william-saxton/crkbd-ice-trackball/cho-corne-ice/pcb/svg/cho-corne-ice-brd.png

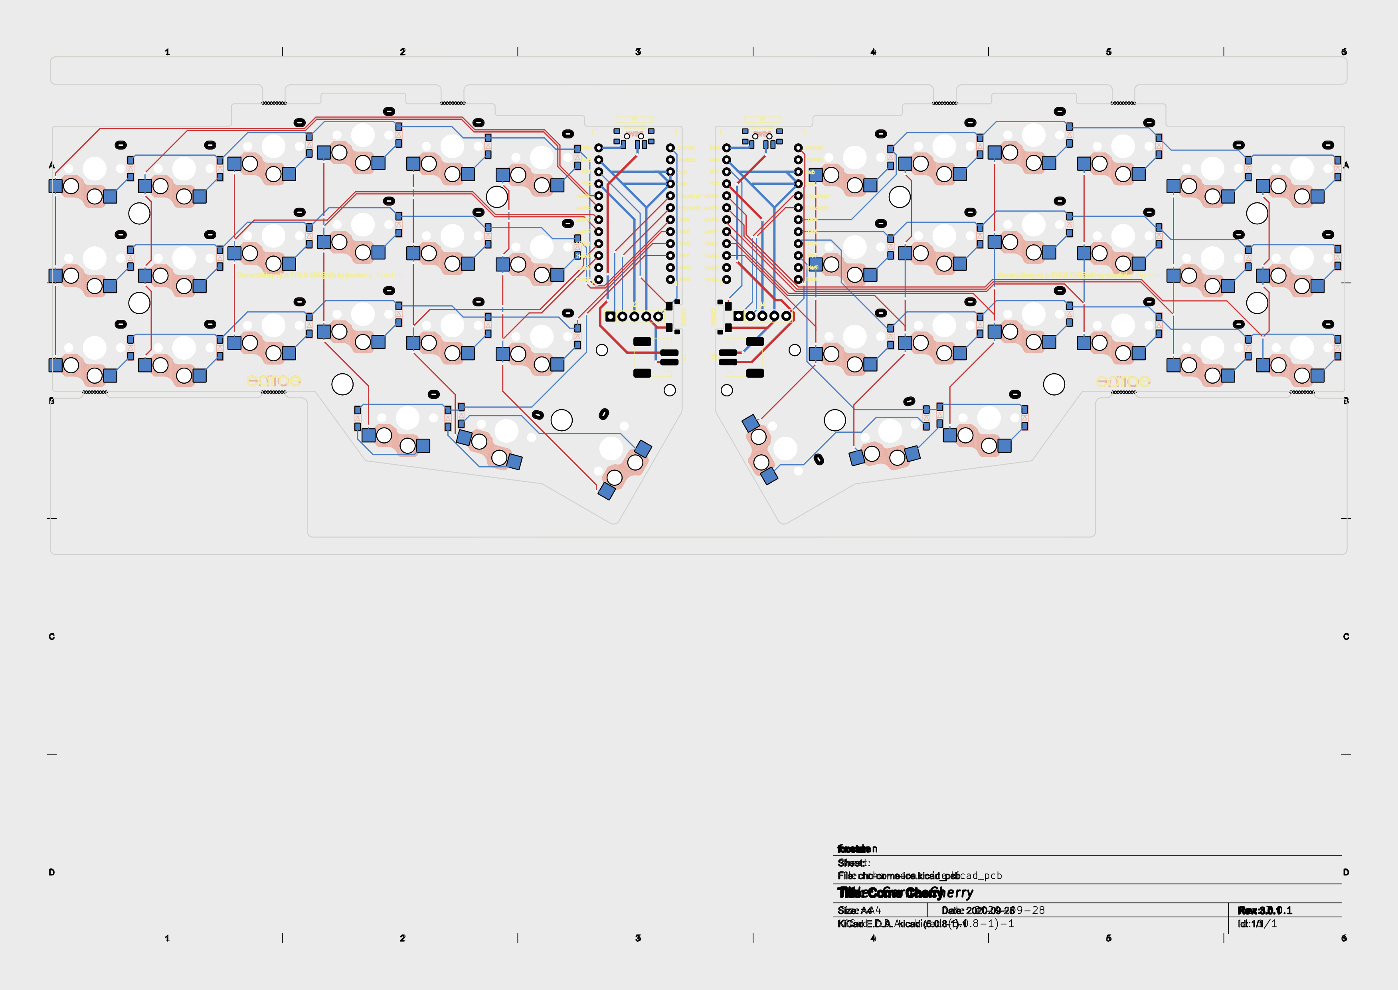
cho-corne-ice/pcb/svg/cho-corne-ice-brd.png
