william-saxton/crkbd-ice-trackball/cho-corne-ice/pcb/svg/cho-corne-ice.png

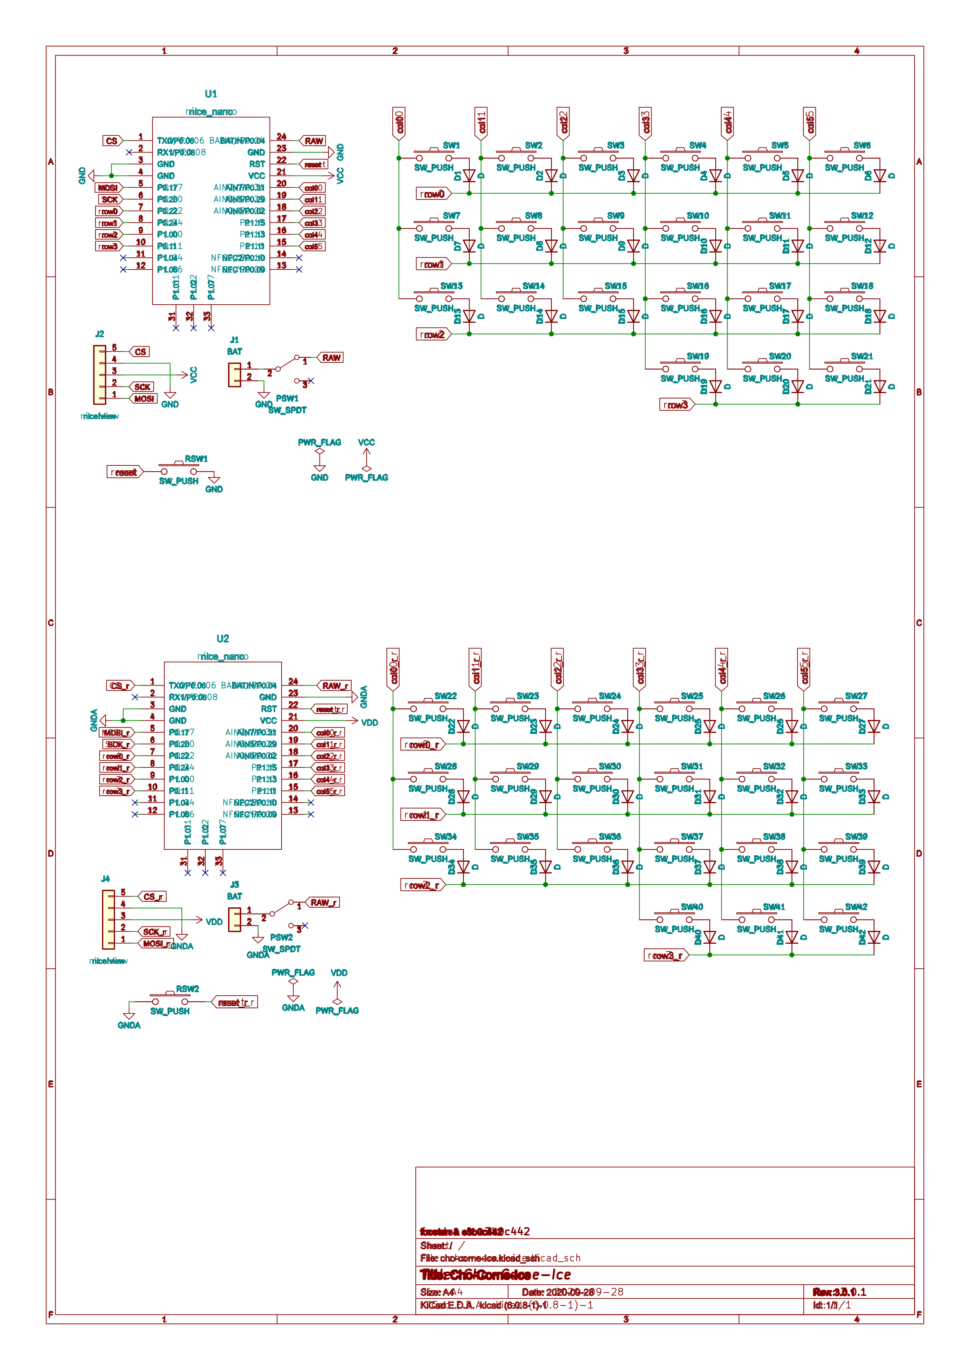
cho-corne-ice/pcb/svg/cho-corne-ice.png
