william-saxton/crkbd-ice-trackball/(commit log)

2022-10-09 copy corne-cherry; remove leds; clean up nets
    [cho-corne-ice.kicad_pcb, cho-corne-ice.kicad_sch, cho-corne-ice.sch]
2022-10-09 mx -> choc hotswap sockets
    [cho-corne-ice.kicad_pcb, cho-corne-ice.kicad_sch]
2022-10-09 add nice!nano, replace Pro Micro footprints with nice!nano
    [cho-corne-ice.kicad_pcb, cho-corne-ice.kicad_sch]
2022-10-10 complete battery jumper and power switch, clean up nets again
    [cho-corne-ice.kicad_pcb, cho-corne-ice.kicad_sch]
2022-10-10 finish switches and nice!view
    [cho-corne-ice.kicad_pcb, cho-corne-ice.kicad_sch]
2022-10-10 tweak footprints
    [cho-corne-ice.kicad_pcb]
2022-10-11 revert reset switches
    [cho-corne-ice.kicad_pcb, cho-corne-ice.kicad_sch]
2022-10-16 complete layout and traces
    [cho-corne-ice.kicad_pcb]
2022-10-21 add pcb
2022-11-18 better labeling
    [cho-corne-ice-B_Cu.gbl, cho-corne-ice-B_Mask.gbs, cho-corne-ice-B_Paste.gbp, cho-corne-ice-B_Silkscreen.gbo, cho-corne-ice-Edge_Cuts.gm1, cho-corne-ice-F_Cu.gtl, cho-corne-ice-F_Mask.gts, cho-corne-ice-F_Paste.gtp]
2022-12-17 start corne-ice; remove leds
    [corne-cherry.kicad_pcb, corne-cherry.kicad_sch, corne-cherry.sch]
2022-12-17 remove trrs
    [corne-cherry.kicad_pcb, corne-cherry.kicad_sch]
2022-12-17 cleanup tracks
    [corne-cherry.kicad_pcb]
2022-12-17 update oled footprint and reroute
    [corne-ice.kicad_pcb, corne-ice.kicad_sch, corne-ice.sch]
2022-12-17 fix battery label on cho-corne-ice
    [cho-corne-ice.kicad_pcb]
2022-12-17 forgot to save schematic
    [cho-corne-ice-B_Cu.gbl, cho-corne-ice-B_Mask.gbs, cho-corne-ice-B_Paste.gbp, cho-corne-ice-B_Silkscreen.gbo, cho-corne-ice-Edge_Cuts.gm1, cho-corne-ice-F_Cu.gtl, cho-corne-ice-F_Mask.gts, cho-corne-ice-F_Paste.gtp]
2022-12-17 reset switch cutout
    [corne-ice.kicad_pcb]
2022-12-17 place remaining footprints
    [corne-ice.kicad_pcb, corne-ice.kicad_sch]
2022-12-17 fix all routes, pass erc
    [corne-ice.kicad_pcb]
2022-12-17 clean up, add gerber files
    [corne-ice.kicad_pcb, corne-ice.kicad_sch]
2022-12-17 ACTUALLY add gerbers
    [cho-corne-ice-B_Cu.gbl, cho-corne-ice-B_Mask.gbs, cho-corne-ice-B_Paste.gbp, cho-corne-ice-B_Silkscreen.gbo, cho-corne-ice-Edge_Cuts.gm1, cho-corne-ice-F_Cu.gtl, cho-corne-ice-F_Mask.gts, cho-corne-ice-F_Paste.gtp]
2024-08-05 Added light ice trackball inital design.
    [BOM-corne-light-ice-trackball.csv, BOM-corne-light.csv, BOM-corne-top-plate.csv, corne-ice.kicad_pcb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]
